lukasjarzembowski/Arduino-TTL-Trigger/(threads)

Thread 1 (2023-10-30):

I cannot run the program

AndreaLagomarsino, 2023-10-30:

lukasjarzembowski, 2023-11-05:
Dear @AndreaLagomarsino - first of all, thank you for finding this repro, I've never thought this little build would be useful for anyone! Since you edited your post I assume you could resolve the issue? Would you be open to sharing how you fixed it for any future users? Since I made a this a while back I haven't really made sure that it works with current versions of Python and the PySimpleGUI library.

Closed 2023-11-12.
